york-fs/kicad-library/README.md

# KiCad Library

A library of shared symbols, footprints, 3D models, and fonts for the YFS KiCad projects.

## Adding to a repository

    git submodule add https://github.com/york-fs/kicad-library.git kicad-library
    
## Updating to the latest version

    git submodule update --remote kicad-library
    git commit -am 'kicad-library: Update to latest version'
