york-fs/kicad-library/models/fuseclip_Schurter _0751.0056.stp

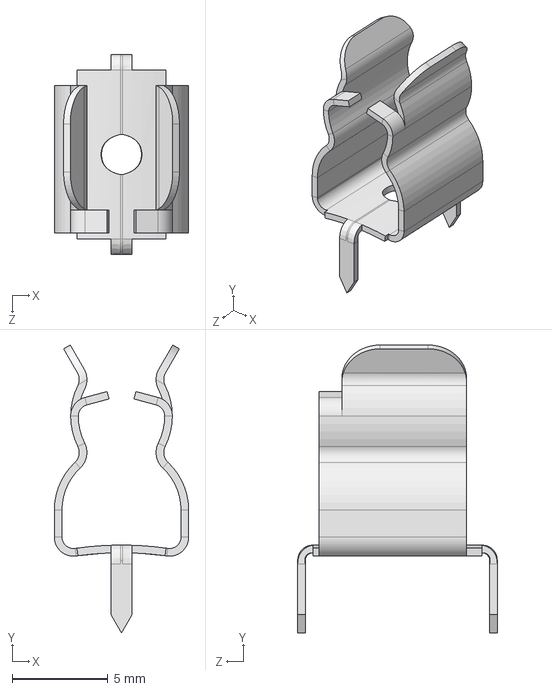
[picture p1: CAD file, 2026-10-18]
models/fuseclip_Schurter _0751.0056.stp
7.00 x 15.0 x 10.4 mm
