york-fs/kicad-library/models/SSO_R06XS_STM.step

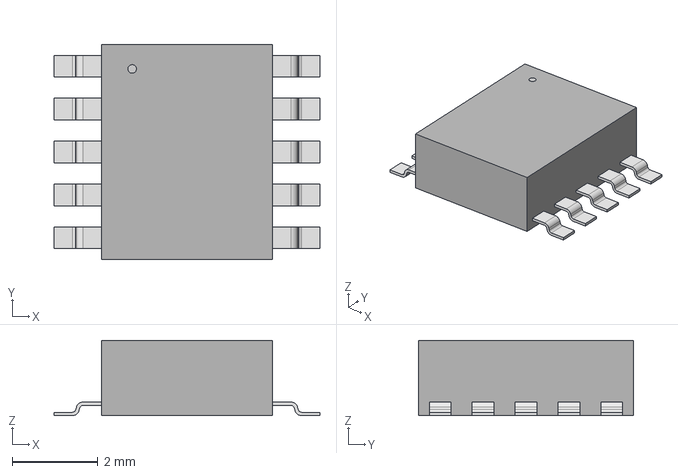
[picture p2: CAD file, 2026-10-18]
models/SSO_R06XS_STM.step
6.20 x 5.00 x 1.75 mm
