york-fs/kicad-library/models/Omron_G9EJH-1-P-E.step

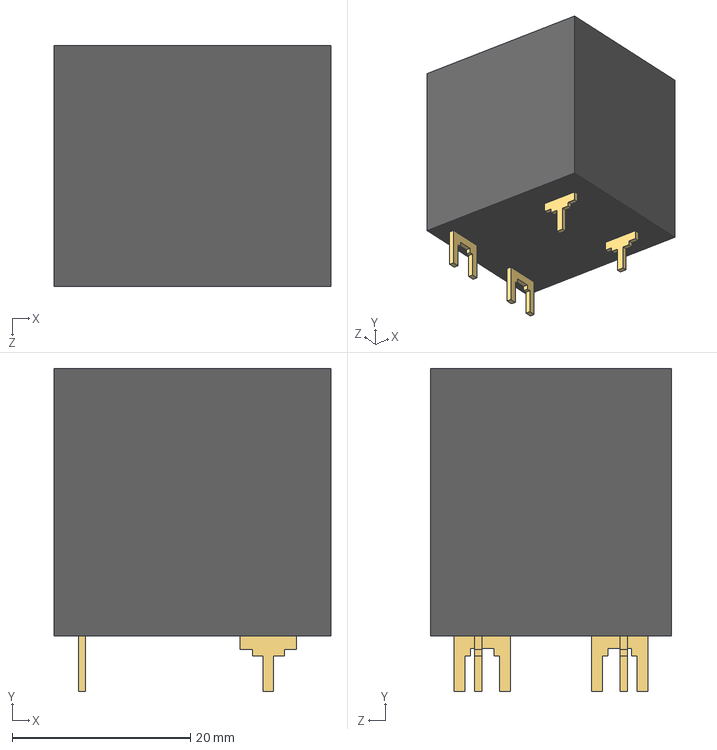
[picture p3: CAD file, 2026-06-28]
models/Omron_G9EJH-1-P-E.step
31.0 x 36.2 x 27.0 mm
