york-fs/kicad-library/models/MolexMicrofitPlus2x3.stp

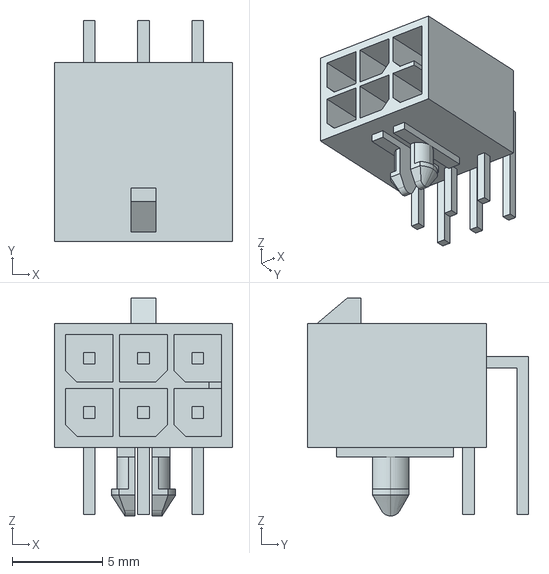
[picture p4: CAD file, 2026-06-19]
models/MolexMicrofitPlus2x3.stp
9.85 x 12.2 x 12.1 mm
