york-fs/kicad-library/models/BAT-SMD_BS-CR2032-8.stp

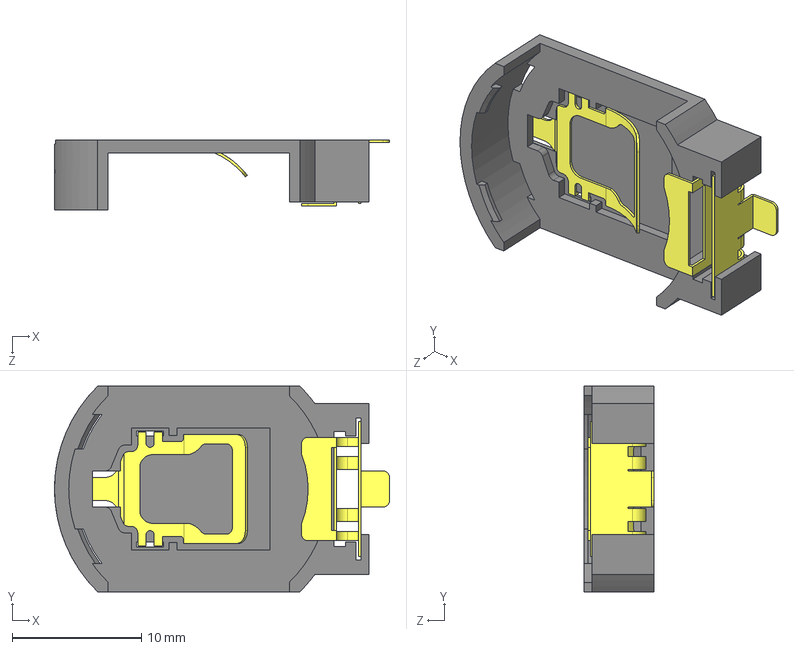
[picture p5: CAD file, 2026-06-16]
models/BAT-SMD_BS-CR2032-8.stp
25.9 x 15.9 x 5.41 mm
