york-fs/kicad-library/models/Keystone_3557-2.stp

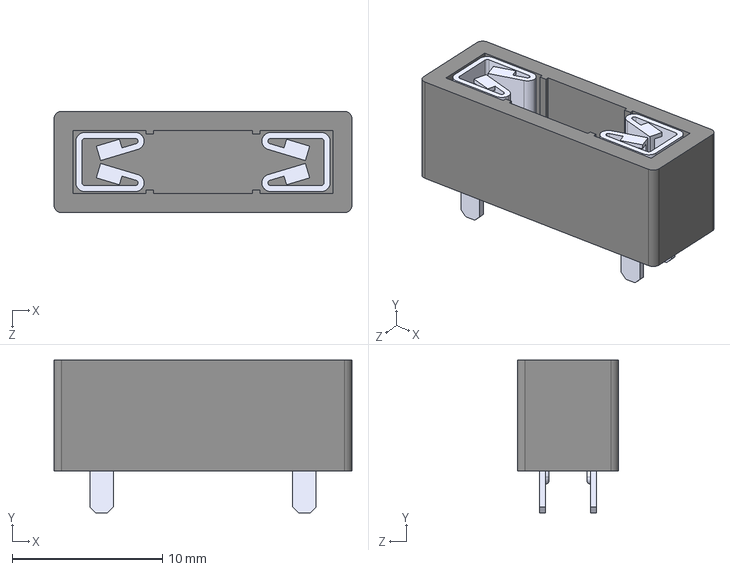
[picture p6: CAD file, 2026-06-16]
models/Keystone_3557-2.stp
19.8 x 10.2 x 6.73 mm
