york-fs/kicad-library/models/AMPSEAL-8-776280.stp

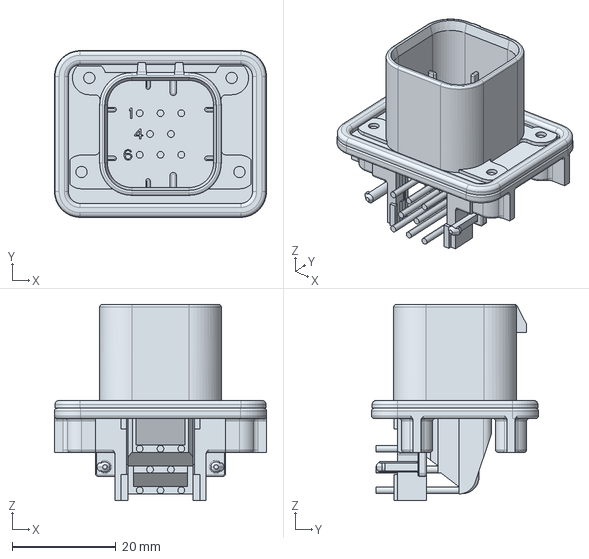
[picture p7: CAD file, 2026-06-03]
models/AMPSEAL-8-776280.stp
40.8 x 32.1 x 37.8 mm
