york-fs/kicad-library/models/AMPSEAL-35-776163.stp

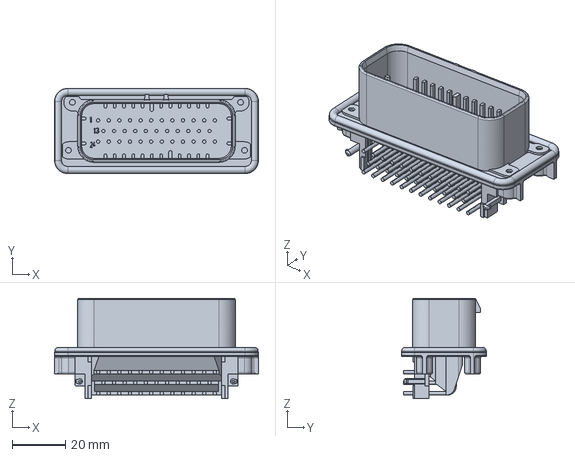
[picture p8: CAD file, 2026-06-03]
models/AMPSEAL-35-776163.stp
76.9 x 32.1 x 37.8 mm
