york-fs/kicad-library/models/AMPSEAL-23-776087.stp

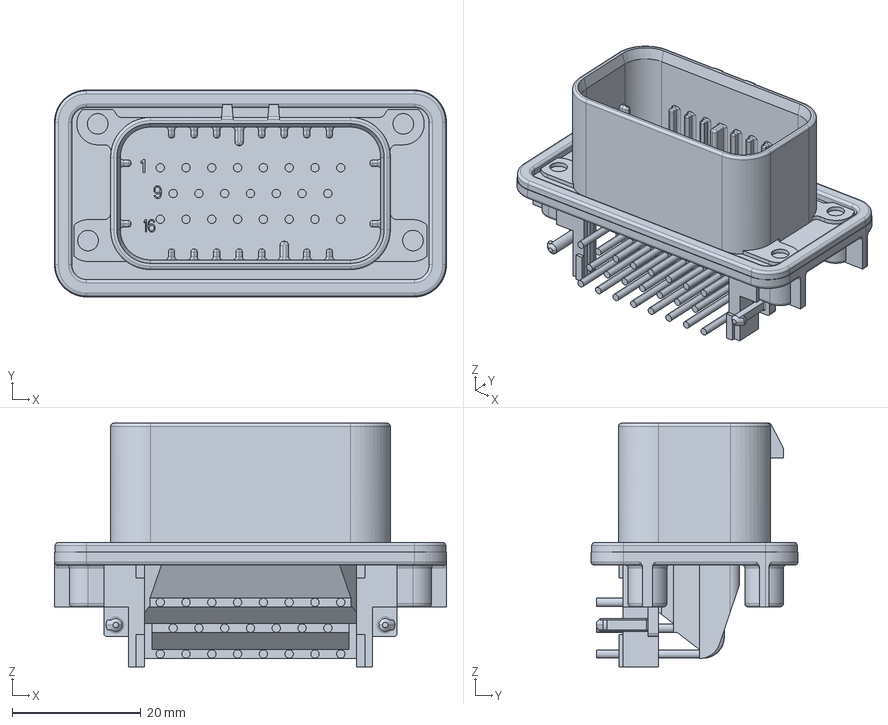
[picture p9: CAD file, 2026-05-16]
models/AMPSEAL-23-776087.stp
60.8 x 32.1 x 37.8 mm
