york-fs/kicad-library/models/5019.step

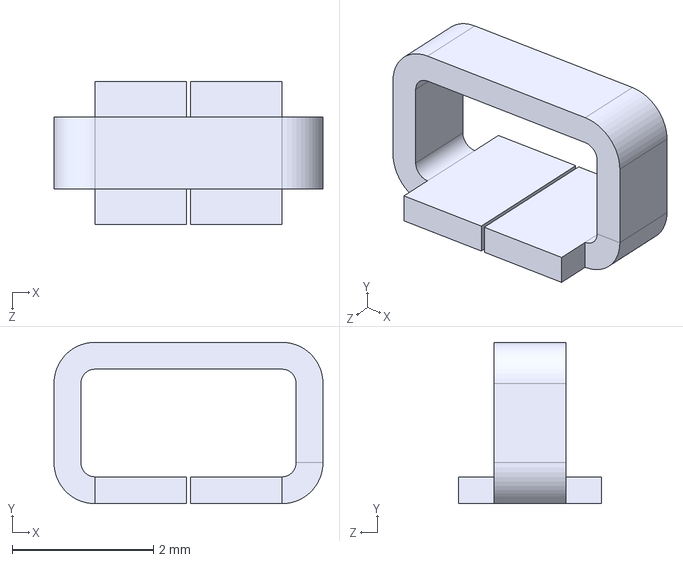
[picture p10: CAD file, 2026-04-25]
models/5019.step
3.81 x 2.29 x 2.03 mm
