york-fs/kicad-library/models/0451.500MRL.stp

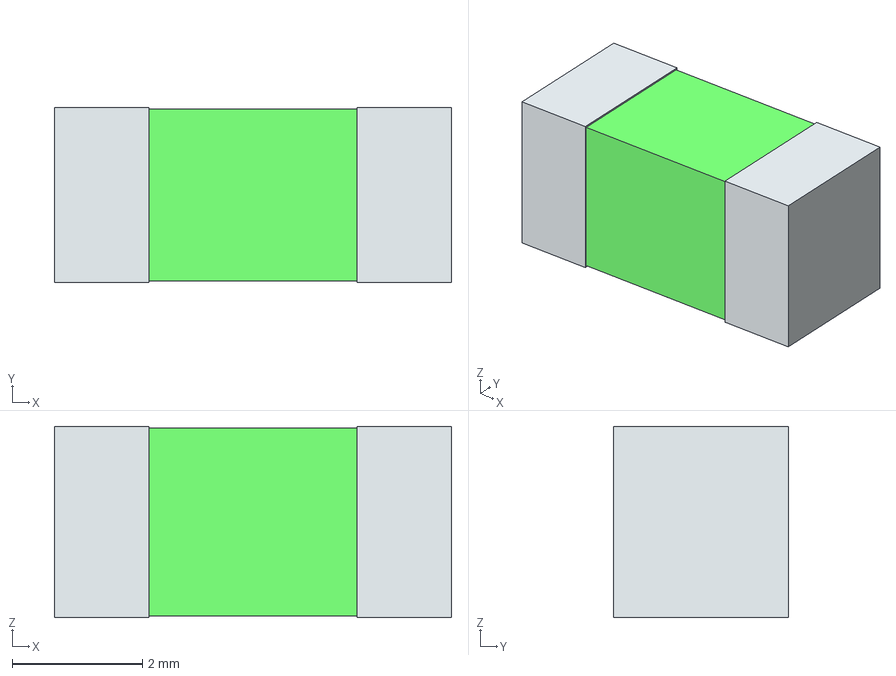
[picture p11: CAD file, 2026-04-25]
models/0451.500MRL.stp
6.10 x 2.69 x 2.94 mm
term1
term2
