york-fs/kicad-library/models/MolexMicrofitPlus2x2-RA.stp

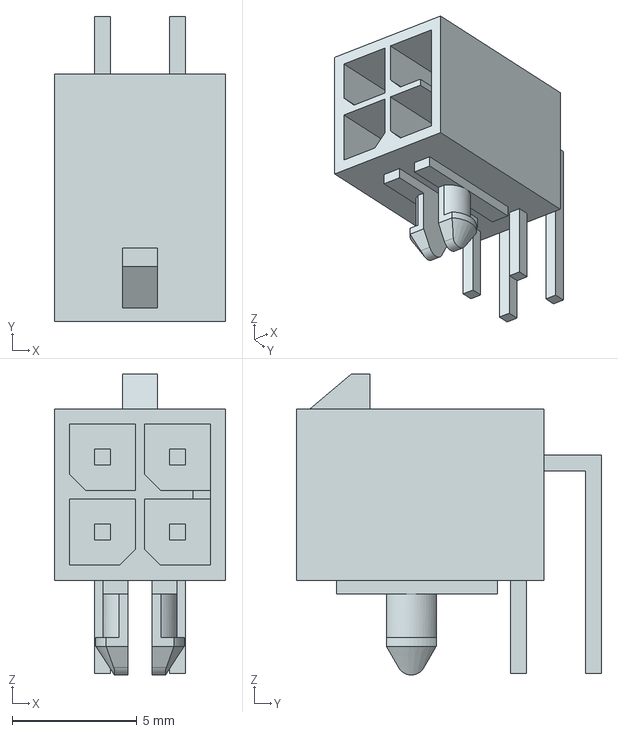
[picture p12: CAD file, 2026-04-14]
models/MolexMicrofitPlus2x2-RA.stp
6.85 x 12.2 x 12.0 mm
