york-fs/kicad-library/models/G2RL_1A.stp

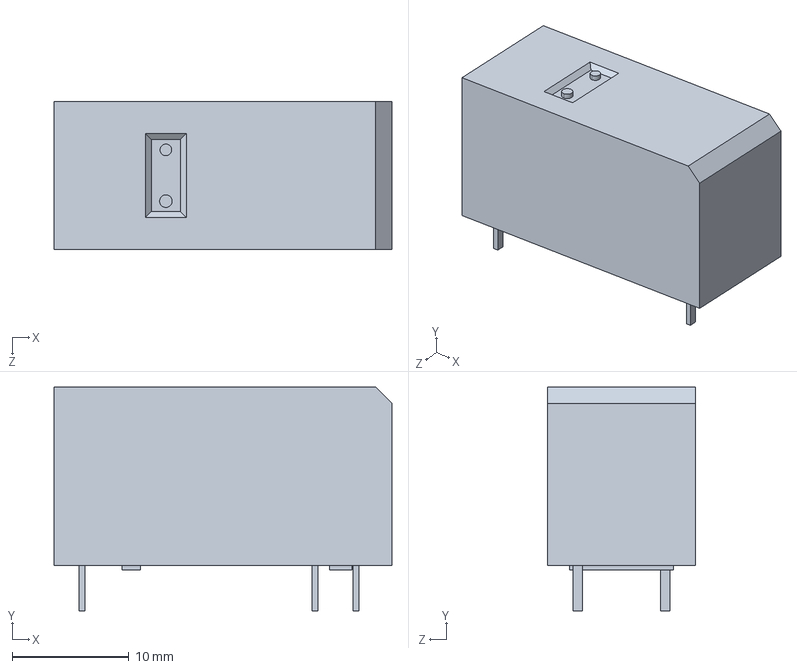
[picture p13: CAD file, 2025-12-17]
models/G2RL_1A.stp
29.0 x 19.2 x 12.7 mm
