york-fs/kicad-library/models/MolexMicrofitPlus1x8.stp

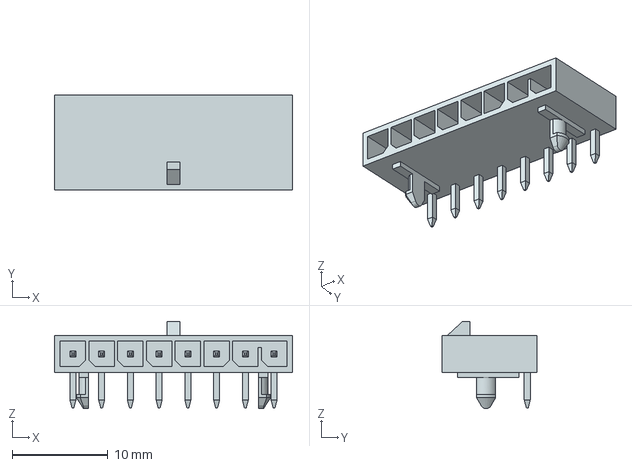
[picture p14: CAD file, 2025-12-14]
models/MolexMicrofitPlus1x8.stp
24.9 x 9.91 x 9.12 mm
