york-fs/kicad-library/models/PowerLed1W.stp

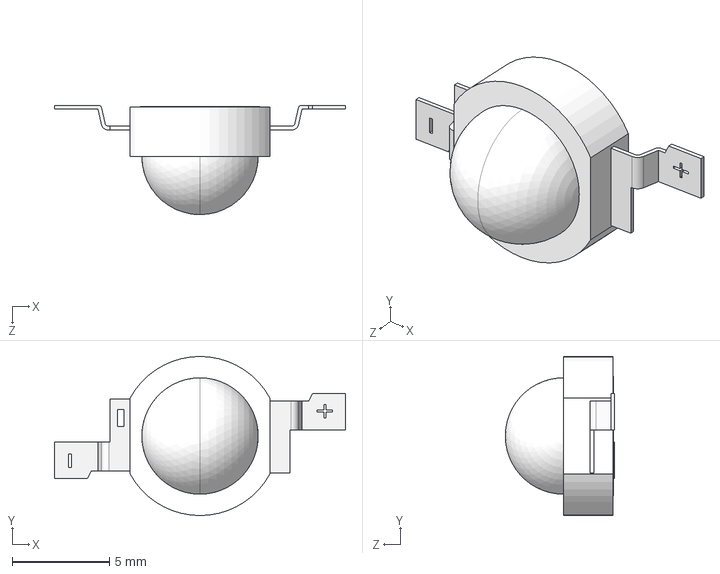
[picture p15: CAD file, 2025-11-16]
models/PowerLed1W.stp
15.0 x 8.20 x 5.64 mm
