york-fs/kicad-library/models/SUMIDA-CDRR105.stp

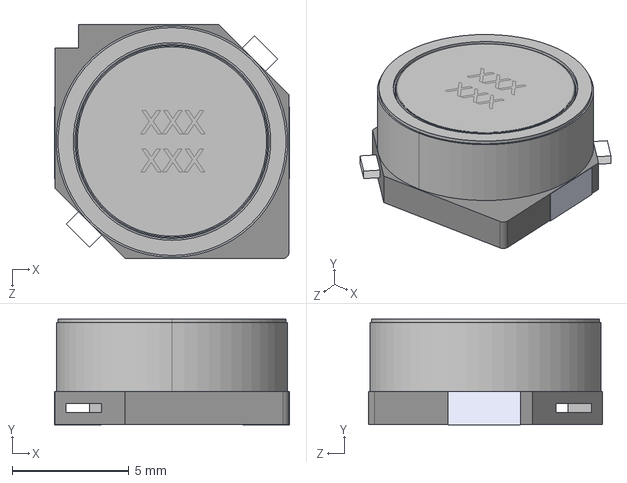
[picture p16: CAD file, 2025-11-16]
models/SUMIDA-CDRR105.stp
10.0 x 4.53 x 10.0 mm
