york-fs/kicad-library/models/RUX0012A.stp

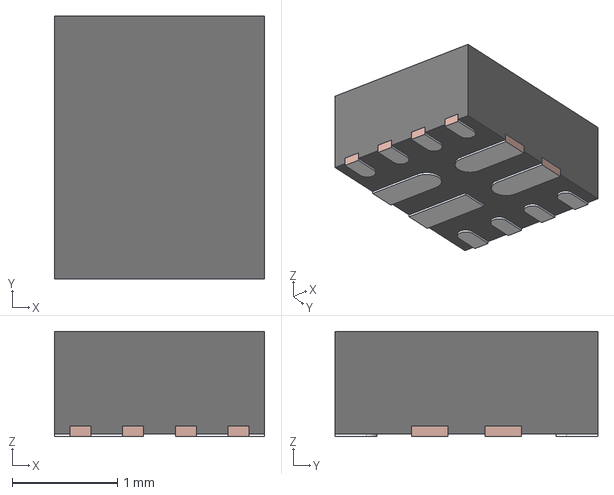
[picture p17: CAD file, 2025-10-30]
models/RUX0012A.stp
2.00 x 2.50 x 1.00 mm
FRAME
MOLD
