york-fs/kicad-library/models/SKRPACE010.stp

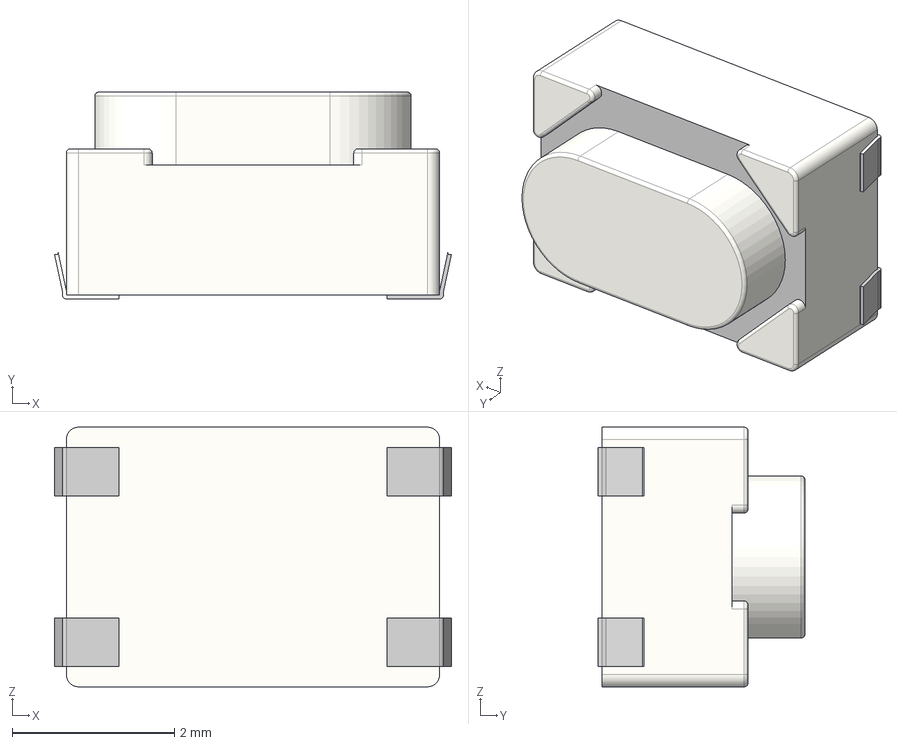
[picture p18: CAD file, 2025-10-26]
models/SKRPACE010.stp
4.89 x 2.55 x 3.20 mm
