york-fs/kicad-library/models/SPU01M-05.step

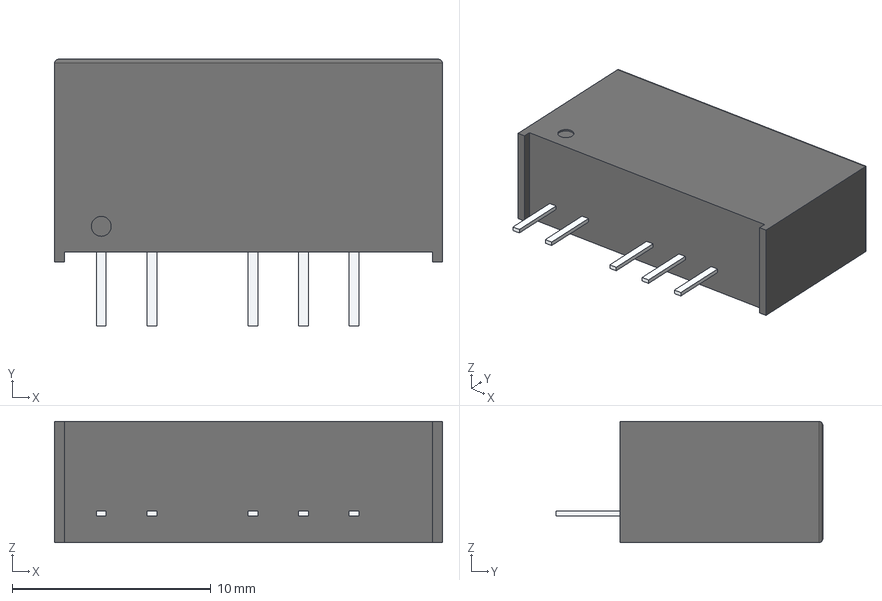
[picture p19: CAD file, 2025-10-25]
models/SPU01M-05.step
19.5 x 13.4 x 6.10 mm
