york-fs/kicad-library/models/MolexMicrofitPlus1x3-Blue.stp

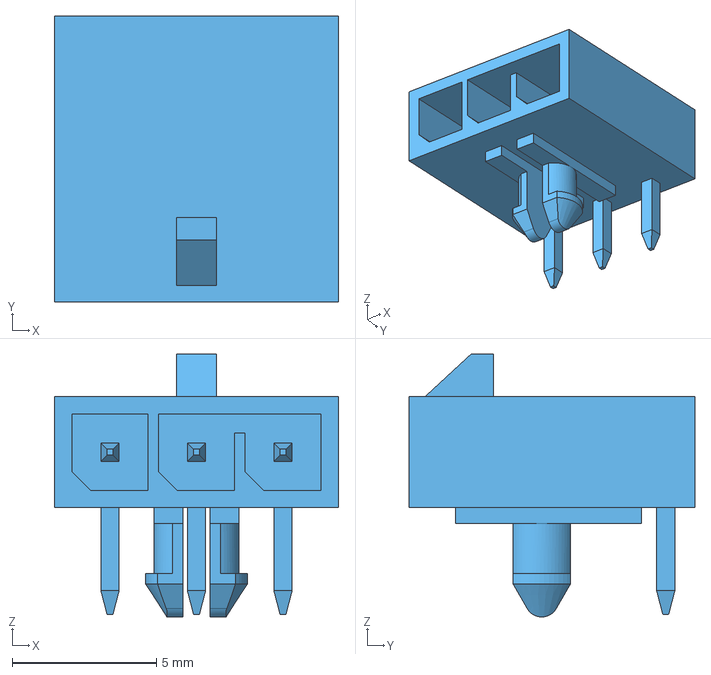
[picture p20: CAD file, 2025-10-24]
models/MolexMicrofitPlus1x3-Blue.stp
9.85 x 9.91 x 9.12 mm
