york-fs/kicad-library/models/MolexMicrofitPlus1x2-Red.stp

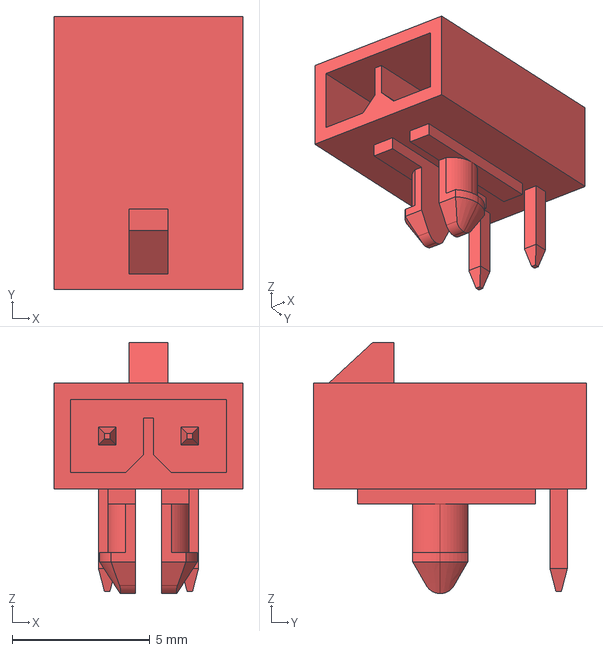
[picture p21: CAD file, 2025-10-24]
models/MolexMicrofitPlus1x2-Red.stp
6.85 x 9.91 x 9.12 mm
