york-fs/kicad-library/models/MolexMicrofitPlus1x4-White.stp

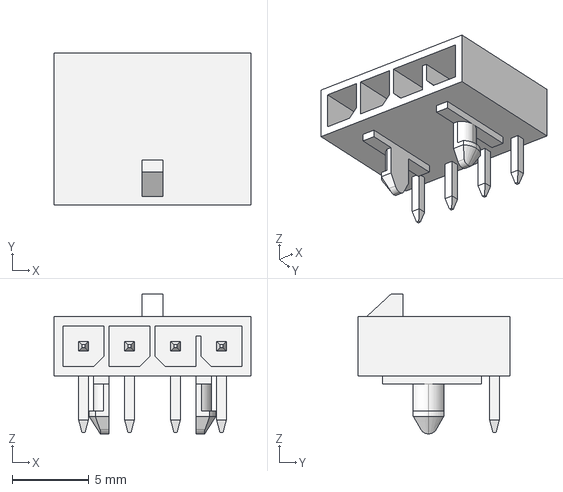
[picture p22: CAD file, 2025-10-24]
models/MolexMicrofitPlus1x4-White.stp
12.8 x 9.91 x 9.12 mm
