york-fs/kicad-library/models/MolexMicrofitPlus1x7-Blue.stp

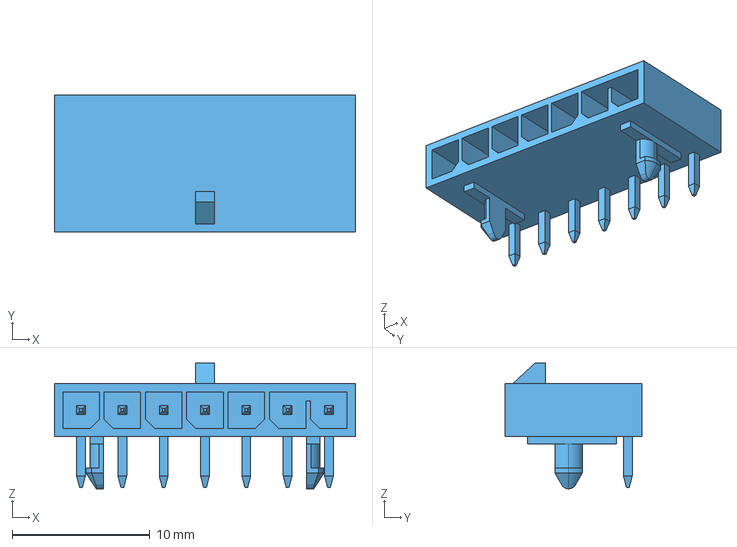
[picture p23: CAD file, 2025-10-24]
models/MolexMicrofitPlus1x7-Blue.stp
21.9 x 9.91 x 9.12 mm
