york-fs/kicad-library/models/IDC-Connector-2x3.step

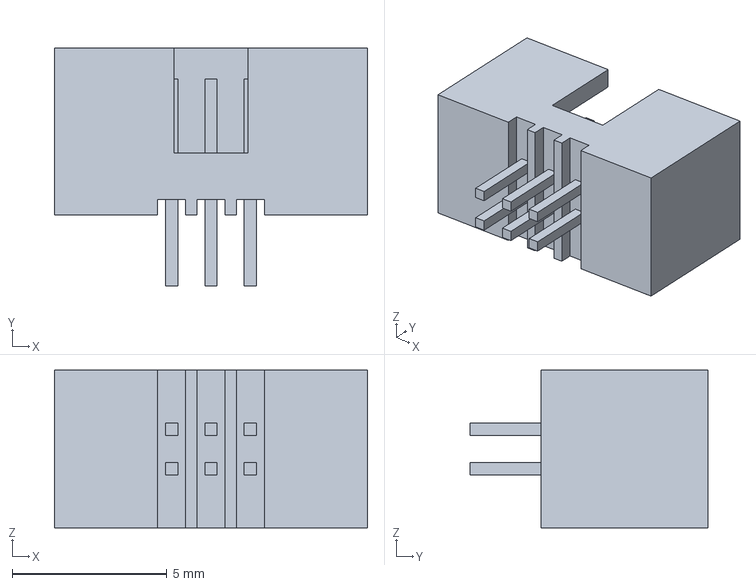
[picture p24: CAD file, 2025-10-12]
models/IDC-Connector-2x3.step
10.1 x 7.70 x 5.10 mm
