york-fs/kicad-library/models/SPU01M-12.stp

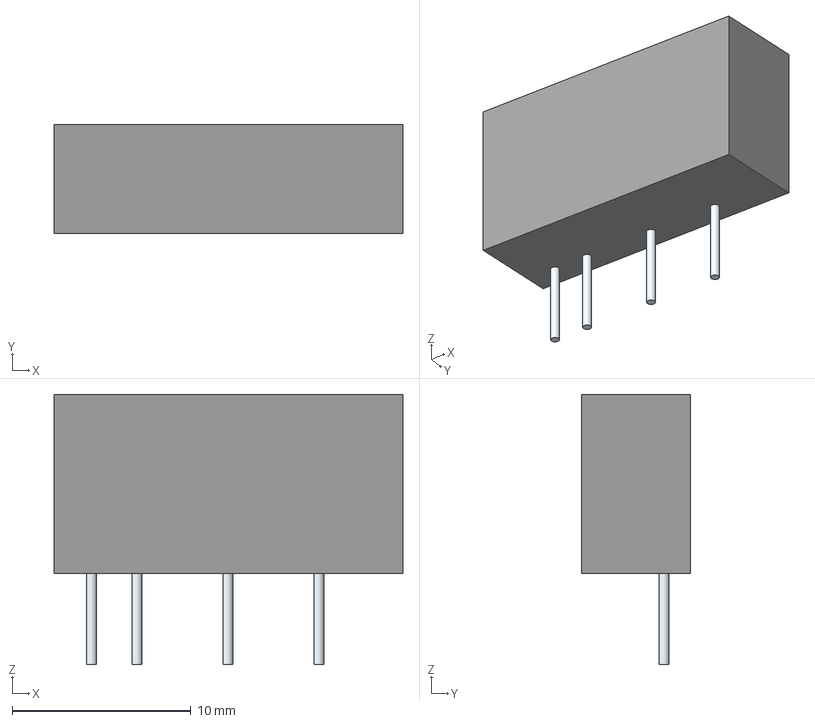
[picture p25: CAD file, 2025-10-11]
models/SPU01M-12.stp
19.5 x 6.10 x 15.1 mm
Leads x 4
