york-fs/kicad-library/models/S20B-PUDSS-1.step

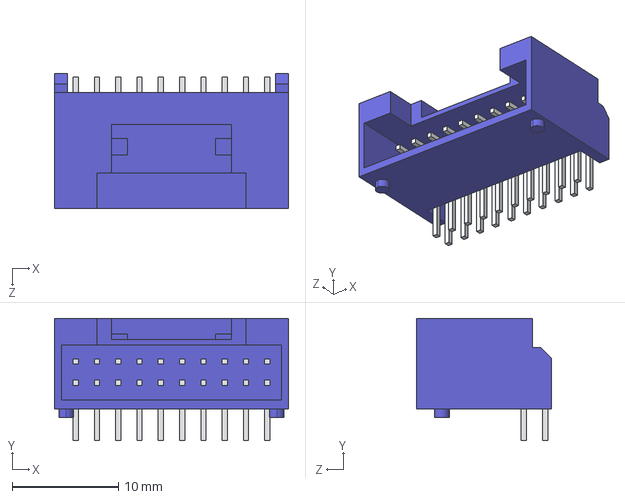
[picture p26: CAD file, 2025-09-28]
models/S20B-PUDSS-1.step
22.0 x 11.5 x 12.7 mm
