york-fs/kicad-library/models/L_Vishay_IHLP-2525.step

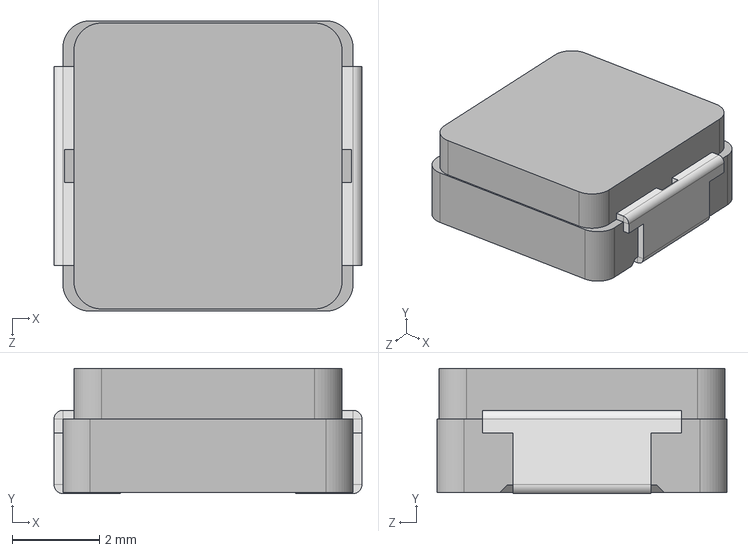
[picture p27: CAD file, 2025-09-28]
models/L_Vishay_IHLP-2525.step
7.08 x 2.88 x 6.67 mm
