york-fs/kicad-library/(list of files, cad)

Other CAD files:
models/MolexMicrofitPlus1x2-Blue.stp
models/MolexMicrofitPlus1x4-Yellow.stp
models/MolexMicrofitPlus1x3-Red.stp
models/MolexMicrofitPlus1x7-White.stp
models/MolexMicrofitPlus1x7-Yellow.stp
models/MolexMicrofitPlus1x4-Red.stp
models/MolexMicrofitPlus1x4-Blue.stp
models/MolexMicrofitPlus1x2-White.stp
models/MolexMicrofitPlus1x3-Yellow.stp
models/MolexMicrofitPlus1x3-White.stp
models/MolexMicrofitPlus1x2-Yellow.stp
models/MolexMicrofitPlus1x7-Red.stp
models/MolexMicrofitPlus1x3.stp
models/MolexMicrofitPlus1x2.stp
models/MolexMicrofitPlus1x7.stp
models/MolexMicrofitPlus1x4.stp
models/2125280400.stp
models/430451400.stp
models/430451600.stp
models/472192001.stp
models/TPS552892RYQR.stp
