york-fs/kicad-library/(commit log)

2025-09-28 footprints: Rename footprint directory
2025-10-11 Added Molex connectors for TSAL_HV_INDICATOR
2025-10-23 footprints: Fix default model paths for molex connectors
2025-10-23 footprints: Update IDC connector
2025-10-24 models: Add Molex Micro-Fit+ Versa colours
    [MolexMicrofitPlus1x2-Blue.stp, MolexMicrofitPlus1x2-Red.stp, MolexMicrofitPlus1x2-White.stp, MolexMicrofitPlus1x2-Yellow.stp, MolexMicrofitPlus1x3-Blue.stp, MolexMicrofitPlus1x3-Red.stp, MolexMicrofitPlus1x3-White.stp, MolexMicrofitPlus1x3-Yellow.stp]
2025-10-26 models: Add SKRPACE010 button model
    [SKRPACE010.stp]
2025-10-29 TPS552892
    36-V 8-A fully-integrated buck-boost converter
    [TPS552892RYQR.stp]
2025-11-03 Updated TPS552892RYQR footprint
2025-11-05 symbols: Add PMV15ENE and PMV74EPE MOSFETs
2025-11-09 footprints: Update Molex connector pin 1 silkscreen
2025-11-16 Updated kicad-library
    [PowerLed1W.stp, SUMIDA-CDRR105.stp]
2025-12-13 footprints: Add 1x8 Micro-Fit+ connector
2025-12-14 models: Add 1x8 Micro-Fit+ connector
    [MolexMicrofitPlus1x8.stp]
2025-12-14 footprints: Add ALPR1000 resistor and G9KB-1A relay
2025-12-14 symbols: Add G9KB-1A relay
2025-12-17 Added precharge components
    [2-1904058-5.stp, G2RL_1A.stp]
2026-04-04 footprints: Add MolexMilliGrid2x9
2026-04-14 Added BMS components
    [2125280400.stp, MolexMicrofitPlus2x2-RA.stp]
2026-04-14 Revert "footprints: Add MolexMilliGrid2x9"
    This reverts commit 2ea94ce8510388f9d078c28f080085a6a5fa82fd.
2026-05-15 footprints: Remove Keystone 5019
    KiCad has this built-in.
2026-05-16 *: Add AMPSEAL 23-pin and MATE-N-LOK 8-pin
    [AMPSEAL-23-776087.stp, MATE-N-LOK-1x8.stp]
2026-06-03 *: Add AMPSEAL 8-pin and 35-pin
    [AMPSEAL-35-776163.stp, AMPSEAL-8-776280.stp]
2026-06-16 footprints: Add SD card, coin cell holder, and fuse holder footprints
2026-06-16 models: Add models for SD card, fuse, and coin cell holders
    [10067847-001RLF.stp, BAT-SMD_BS-CR2032-8.stp, Keystone_3557-2.stp]
2026-06-18 footprints: Move footprint anchor for blade fuse holder
2026-06-18 footprints: Add Micro-Fit+ 2x3 connector
2026-06-19 *: Switch to Molex SD card slot
    [10067847-001RLF.stp, 472192001.stp]
2026-06-19 models: Add MF+ 2x3 model
    [MolexMicrofitPlus2x3.stp]
2026-06-28 models: Add precharge relay model
    [2-1904058-5.stp, MATE-N-LOK-1x8.stp, Omron_G9EJH-1-P-E.step]
